harxh1t/PowerSense-IoT-Energy-Monitor/images/hardware_setup_wide.jpg

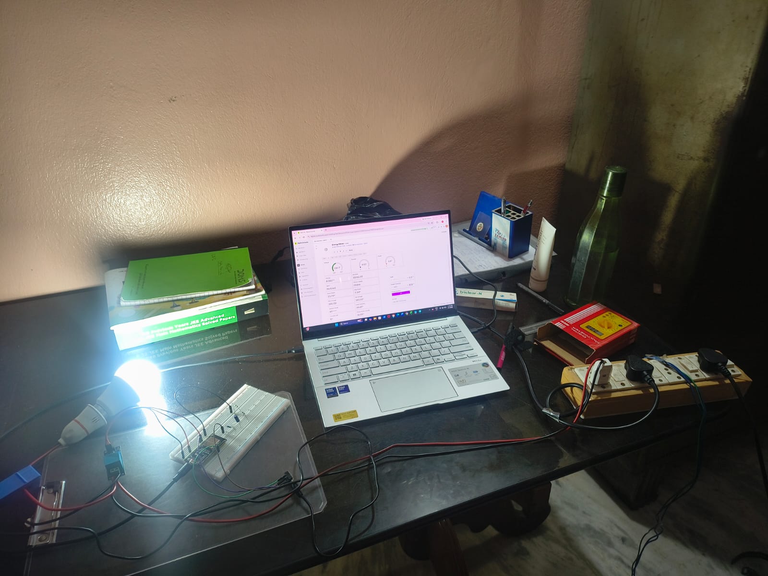
images/hardware_setup_wide.jpg
