harxh1t/PowerSense-IoT-Energy-Monitor/(commit log)

2026-11-04 Initial commit: PowerSense IoT Energy Monitor - firmware, cloud telemetry, images, and experimental findings
2026-11-04 Update firmware comments with project credentials and replace Google Script link with template placeholder
    [PowerSense_ESP32.ino]
2026-11-04 Add detailed circuit diagram, hardware setup, and signal conditioning; remove fan dashboard image
